Nahaa0711/Micromouse-UofT/Notes/MM Kahoot.md

\1.How many Prototypes have we made so far?
2.How many degrees of freedom does a Micromouse typically have? 
3.Pick a sensor we haven't used
4.Increasing **wheel diameter** tends to:  
    A. Improve torque but reduce top speed  
    B. Reduce ground clearance  
    C. Increase angular acceleration  
    D. Boost top speed but require more torque
