Nahaa0711/Micromouse-UofT/Important Links/LINKS.md

**Obsidian Documentation Github**
- https://github.com/AahanP711/Micromouse-Documentation
- contains the Obsidian repo!

**KiCad Tutorial**
- Installing KiCad
	- [installing KiCad](https://docs.google.com/document/d/1HKX35Z9dQBu9zBemlAzxbzjGxq4VL6n00p6JnvmTeCc/edit?usp=sharing)
- KiCad Starter Tutorial

**GIT HELP**
- [[Read Me]]
