Nahaa0711/Micromouse-UofT/KB/SLAM.md

The **Simultaneous Localization and Mapping (SLAM)** problem is the **holy grail** of autonomous navigation in unknown environments. It tackles the **chicken-and-egg dilemma**: how do you build a map if you don't know where you are, and how do you know where you are if you don't have a map? SLAM algorithms solve this by **concurrently estimating** both the agent's (robot's) pose (position and orientation) and the structure of its surrounding environment.

At its core, SLAM is a **probabilistic state estimation problem**. It fuses noisy, sequential sensor data (from LiDAR, cameras, IMUs, odometers, etc.) with motion models to recursively update a **joint probability distribution** over the robot's pose and the map features.

Key components and challenges include:

1. **Front-End (Perception & Odometry)**: This involves processing raw sensor data to extract useful information.
    - **Feature Extraction**: Identifying salient, repeatable landmarks or features (e.g., corners, edges, distinct points, planes) from sensor readings.
    - **Data Association**: The **"correspondence problem"** – correctly matching current sensor observations to previously observed map features or new features. This is _critical_ and prone to error in dynamic or feature-poor environments.
    - **Visual/Lidar Odometry**: Estimating the robot's relative motion between consecutive sensor frames. This provides a short-term, but drift-prone, pose estimate.
        
2. **Back-End (Optimization & Map Management)**: This component refines the pose and map estimates over time.
    - **State Estimation Techniques**:
        - **Filter-based SLAM** (e.g., Extended Kalman Filter (EKF) SLAM, Unscented Kalman Filter (UKF) SLAM, Particle Filter SLAM like FastSLAM): Recursively updates a single state estimate (or a set of particles) and its covariance. EKF-SLAM linearizes non-linear models, while particle filters handle multi-modal distributions.
        
        - **Graph-based SLAM**: Formulates the problem as a pose graph where nodes are robot poses/landmarks and edges are spatial constraints derived from sensor measurements or odometry. The optimal map and trajectory are found by solving a **nonlinear least-squares optimization problem** to minimize errors across the entire graph. This is often more scalable for large environments.
        
    - **Loop Closure Detection**: The **holy grail of consistency**. When the robot revisits a previously mapped area, loop closure algorithms (e.g., using Bag-of-Words for place recognition) detect this re-visitation. This allows for the **global correction of accumulated drift** in both the map and the robot's trajectory, pulling the entire map into a consistent state.
    
    - **Map Representation**: The environment can be represented as occupancy grids, point clouds, feature maps, or topological maps, each with trade-offs in detail, memory, and computational cost.

The primary challenges in SLAM stem from **sensor noise**, **data association ambiguity**, **computational complexity** (especially for large-scale or real-time applications), and operating in **dynamic environments** where the map itself changes. Despite these hurdles, ongoing research, particularly with the integration of machine learning and deep learning, continues to push the boundaries, making SLAM indispensable for autonomous vehicles, robotics, and augmented reality.
