Nahaa0711/Micromouse-UofT/Notes/Daniel's top 5 designs.md

Top 5 Designs
https://www.kerislab.jp/posts/2020-04-15-kerise-v5-coming/
https://github.com/Ojasp21/Micromouse?tab=readme-ov-file#about-the-project
https://github.com/sanjith1999/SINDiB-MicroMouse
https://github.com/kbumsik/WolfieMouse
https://github.com/opatiny/micromouse

Top 5 Vision Systems
https://github.com/emstef/Micromouse
https://github.com/Bugaddr/micromouse_rac_task
https://github.com/adam2392/ieee_micromouse
https://ianmhoffman.github.io/Micromouse/#wall-sensors
https://github.com/arnefmeyer/mousecam
https://www.xiaotiandai.com/robots/

Top 5 Mobility Systems
https://kyle-chan.github.io/projects/micromouse
https://gingineer95.github.io/2021/12/11/micromouse/
https://medium.com/@austinxiao/ieee-micromouse-2016-software-design-496653ff104d
https://github.com/ukmars/turn-tuner
https://github.com/gautam-dev-maker/mushak

weight
