Nahaa0711/Micromouse-UofT/Notes/Component Selection.md

BOOK - GERSTEIN BASEMENT
BOOK - MYHAL 360

syncsearch - avIlable rooms
BOOK - UC basement

Gideons favourite numbers - 6, 7

Micromouse Size - Full

Motor
https://www.pololu.com/product/5154
- encoder ( maybe find better encoder to reduce 3 degree error)
- buck boost converter since motor is 6V
	- or 6V battery

Wheels
https://ca.robotshop.com/products/pololu-wheel-32-7mm-black-pair?qd=e8f42962d0da45bdb59b51051e12fbfa
- maybe try 3D printing wheels too
