Nahaa0711/Micromouse-UofT/Micromouse/ECS_80_18_30_JGN_TR/ECS-80-18-30-JGN-TR.step

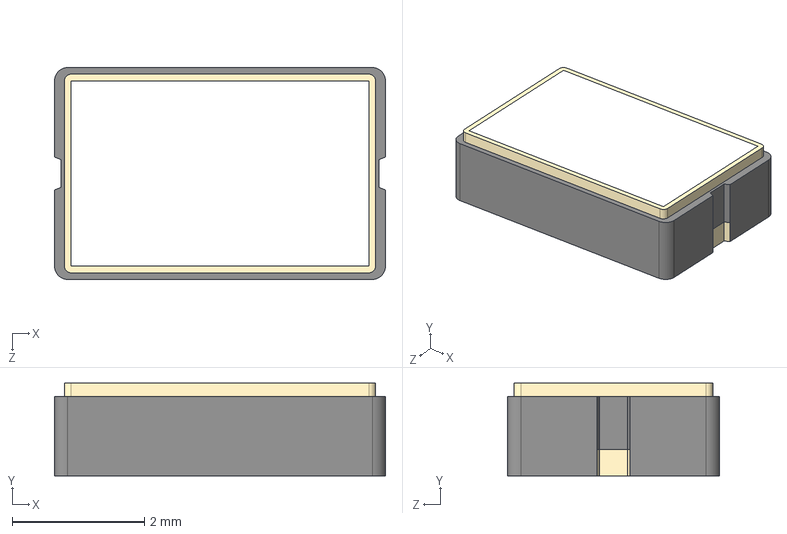
[picture p1: CAD file, 2026-10-29]
Micromouse/ECS_80_18_30_JGN_TR/ECS-80-18-30-JGN-TR.step
5.00 x 1.40 x 3.20 mm
