Nahaa0711/Micromouse-UofT/Micromouse/ICM_42688_P/ICM-42688-P.step

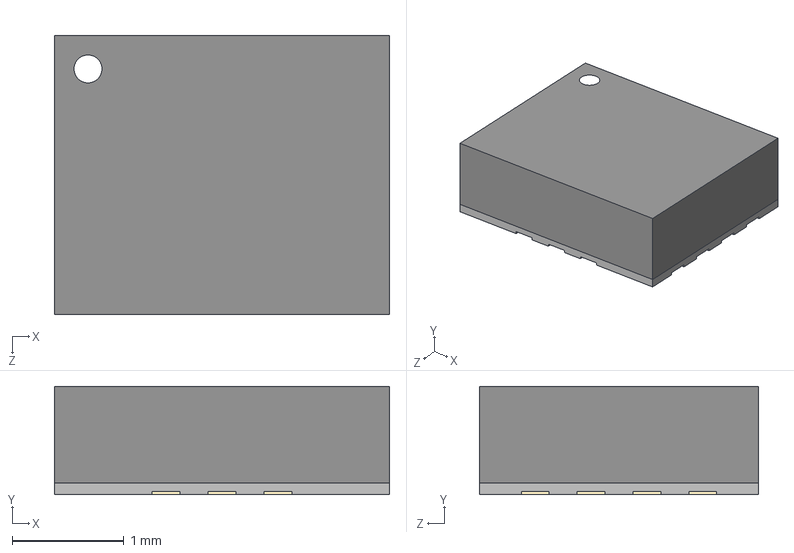
[picture p2: CAD file, 2025-10-28]
Micromouse/ICM_42688_P/ICM-42688-P.step
3.00 x 0.97 x 2.50 mm
