Nahaa0711/Micromouse-UofT/Micromouse/LIS2MDLTR/LIS2MDLTR.step

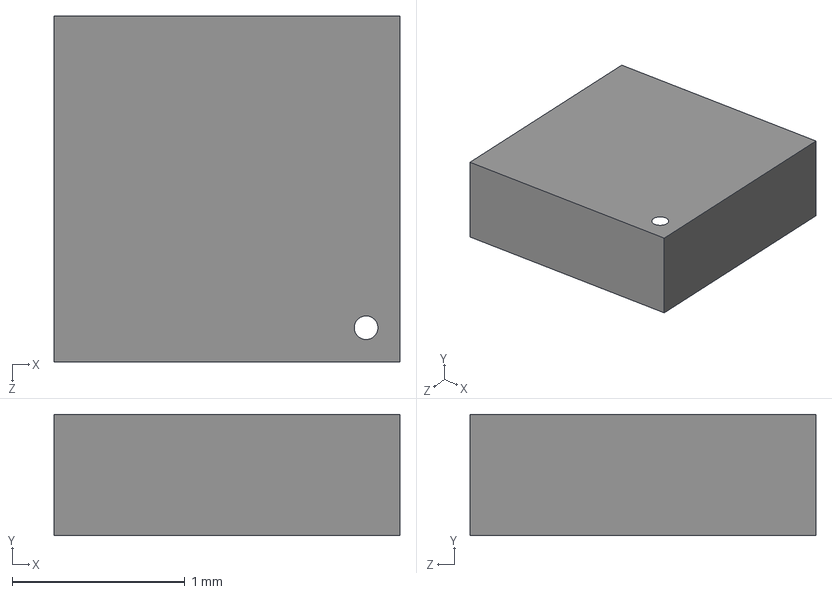
[picture p3: CAD file, 2025-10-28]
Micromouse/LIS2MDLTR/LIS2MDLTR.step
2.00 x 0.7 x 2.00 mm
