Nahaa0711/Micromouse-UofT/Micromouse/LP5907MFX_2_8_NOPB/LP5907MFX-2.8_NOPB.step

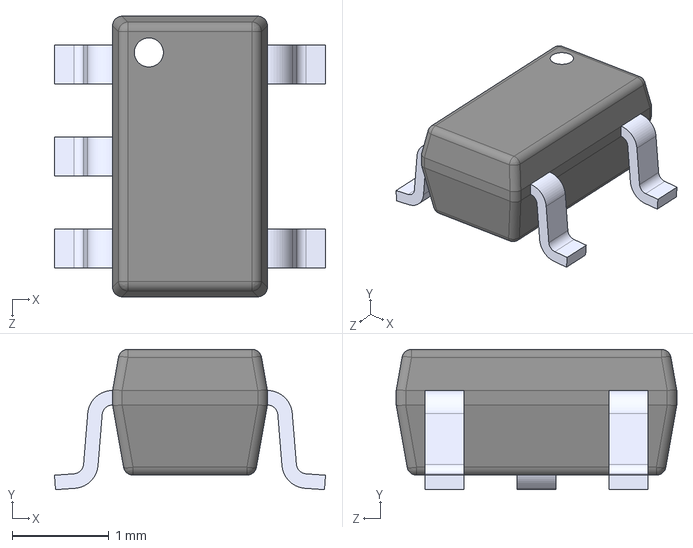
[picture p4: CAD file, 2025-11-02]
Micromouse/LP5907MFX_2_8_NOPB/LP5907MFX-2.8_NOPB.step
2.80 x 1.45 x 2.90 mm
