Nahaa0711/Micromouse-UofT/Micromouse/pcb_shape.DXF

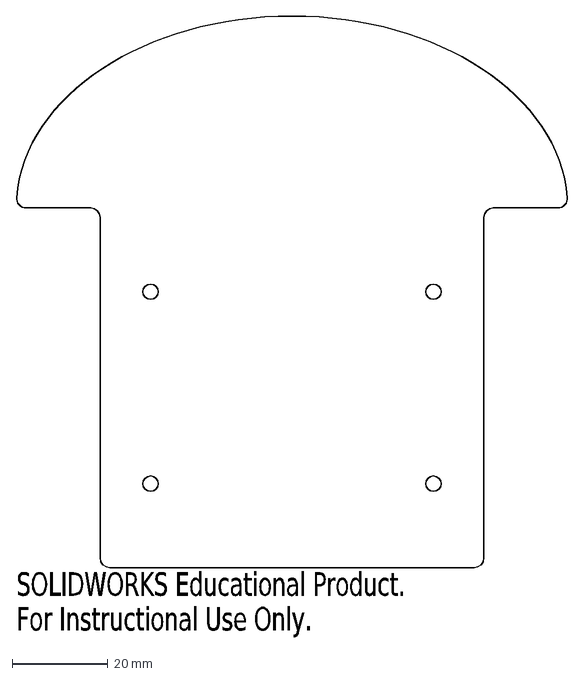
[picture p5: CAD file, 2026-08-07]
Micromouse/pcb_shape.DXF
SOLIDWORKS Educational Product.
For Instructional Use Only.
