Nahaa0711/Micromouse-UofT/Micromouse/TCA9544APWR/TCA9544APWR.step

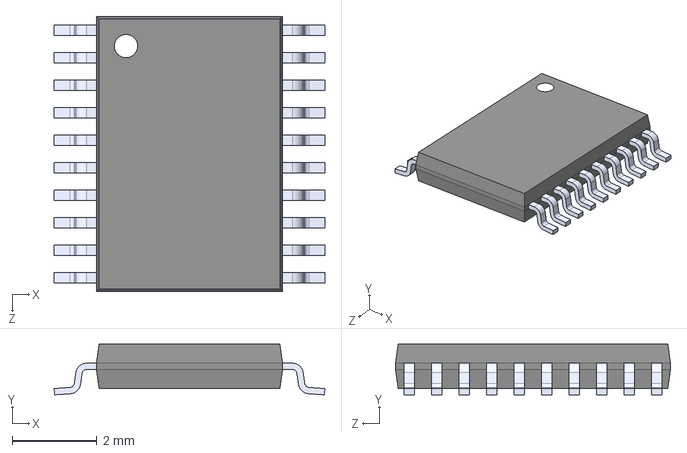
[picture p6: CAD file, 2025-11-02]
Micromouse/TCA9544APWR/TCA9544APWR.step
6.40 x 1.20 x 6.50 mm
