Nahaa0711/Micromouse-UofT/Micromouse/TPSM861253RDXR/TPSM861253RDXR.step

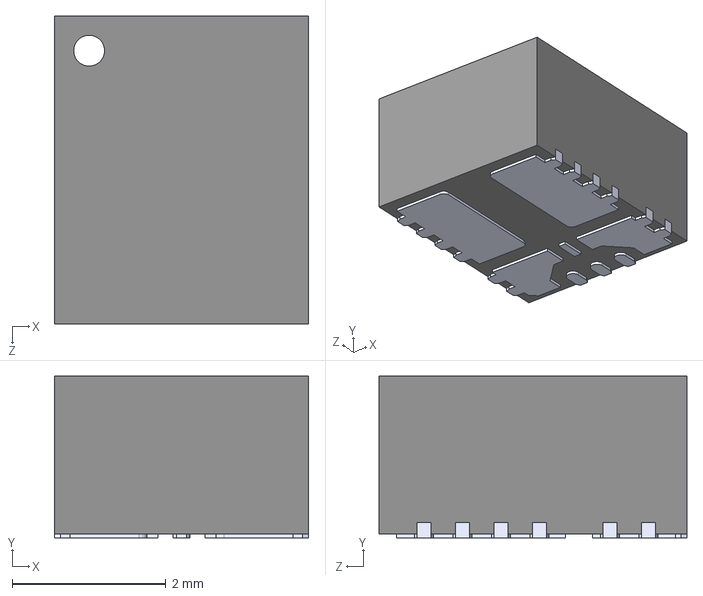
[picture p7: CAD file, 2025-10-28]
Micromouse/TPSM861253RDXR/TPSM861253RDXR.step
3.30 x 2.10 x 4.00 mm
