Nahaa0711/Micromouse-UofT/Micromouse/VL6180V1NR_1/VL6180V1NR_1.step

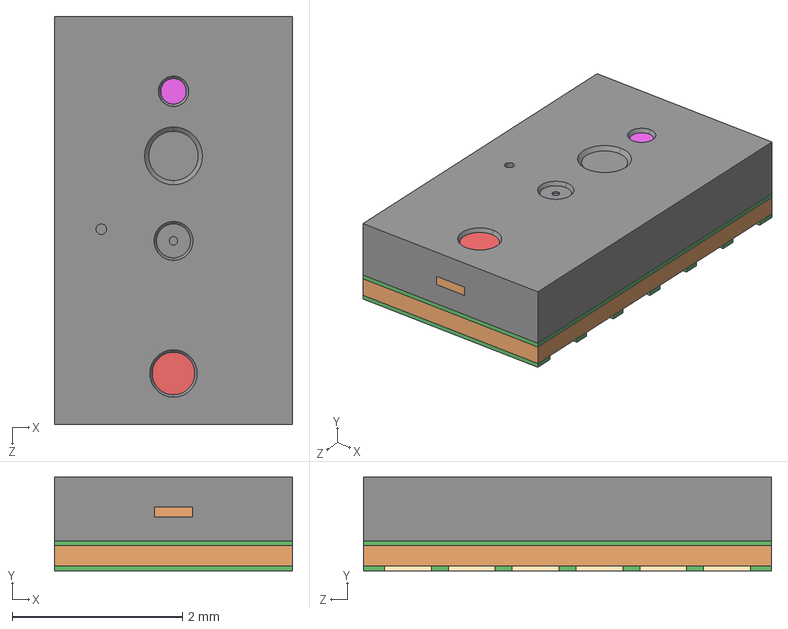
[picture p8: CAD file, 2025-10-28]
Micromouse/VL6180V1NR_1/VL6180V1NR_1.step
2.80 x 1.10 x 4.80 mm
