Nahaa0711/Micromouse-UofT/Micromouse/IR_sensor_project/IR_sensor_project.kicad_pcb

## KiCad design Micromouse/IR_sensor_project/IR_sensor_project.kicad_pcb (2026-10-29)

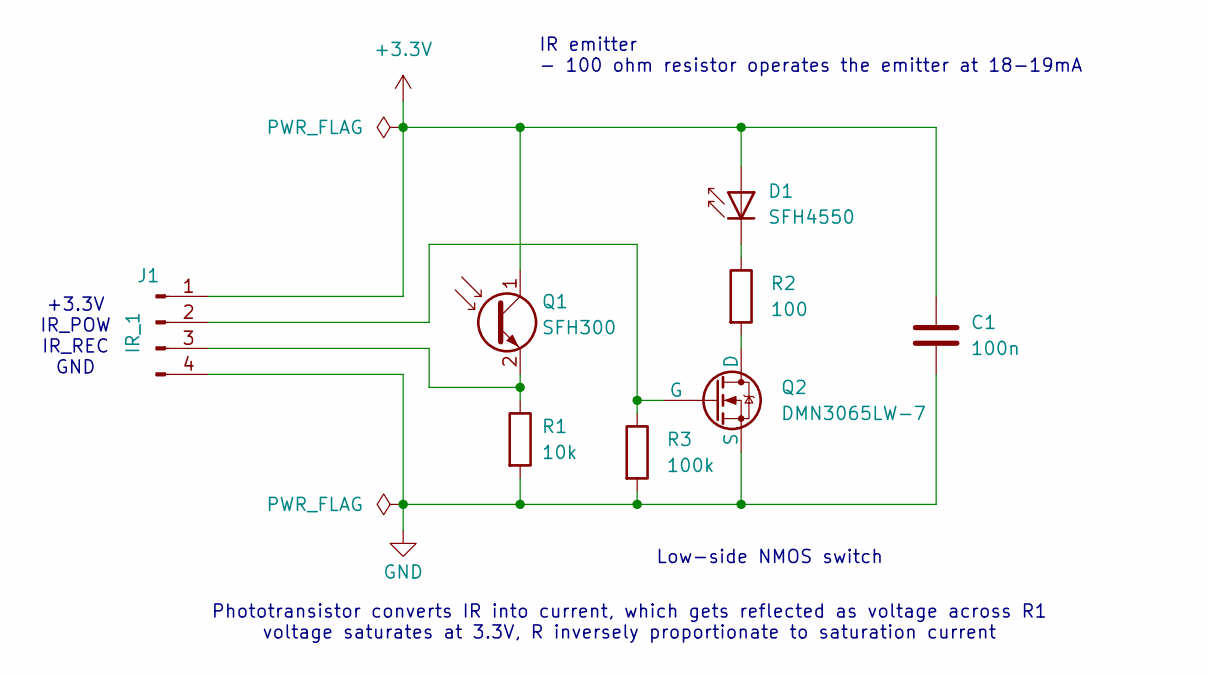
[picture p9: schematic IR_sensor_project.kicad_sch]

Parts:
C1: 100n; C_0603_1608Metric
D1: SFH4550; LED_D5.0mm_IRGrey
J1: IR_1; PinHeader_1x04_P2.00mm_Horizontal
Q1: SFH300; LED_D5.0mm_Clear
Q2: DMN3065LW-7
R1: 10k; R_0603_1608Metric
R2: 100; R_0603_1608Metric
R3: 100k; R_0603_1608Metric

Connections:
+3.3V: C1.1, D1.2 (A), J1.1, Q1.1 (C)
GND: C1.2, J1.4, Q2.3 (S), R1.2, R3.2
unnamed: D1.1 (K), R2.1
unnamed: J1.2, Q2.2 (G), R3.1
unnamed: J1.3, Q1.2 (E), R1.1
unnamed: Q2.1 (D), R2.2

Notes on the sheet:
Low-side NMOS switch
Phototransistor converts IR into current, which gets reflected as voltage across R1 voltage saturates at 3.3V, R inversely proportionate to saturation current
IR emitter - 100 ohm resistor operates the emitter at 18-19mA
+3.3V IR_POW IR_REC GND

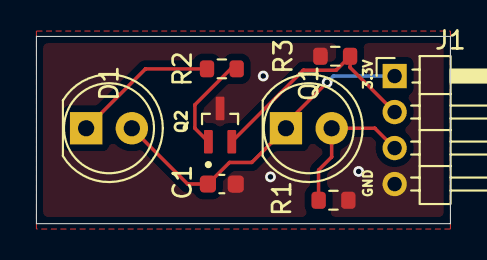
[picture p10: board IR_sensor_project.kicad_pcb from above]

Board: 2 copper layers, 23.0 x 10.4 mm, 8 parts (0 on the bottom side), 6 nets.
