Nahaa0711/Micromouse-UofT/Micromouse/ToF_sensor_project/ToF_sensor_project.kicad_pcb

## KiCad design Micromouse/ToF_sensor_project/ToF_sensor_project.kicad_pcb (2026-10-29)

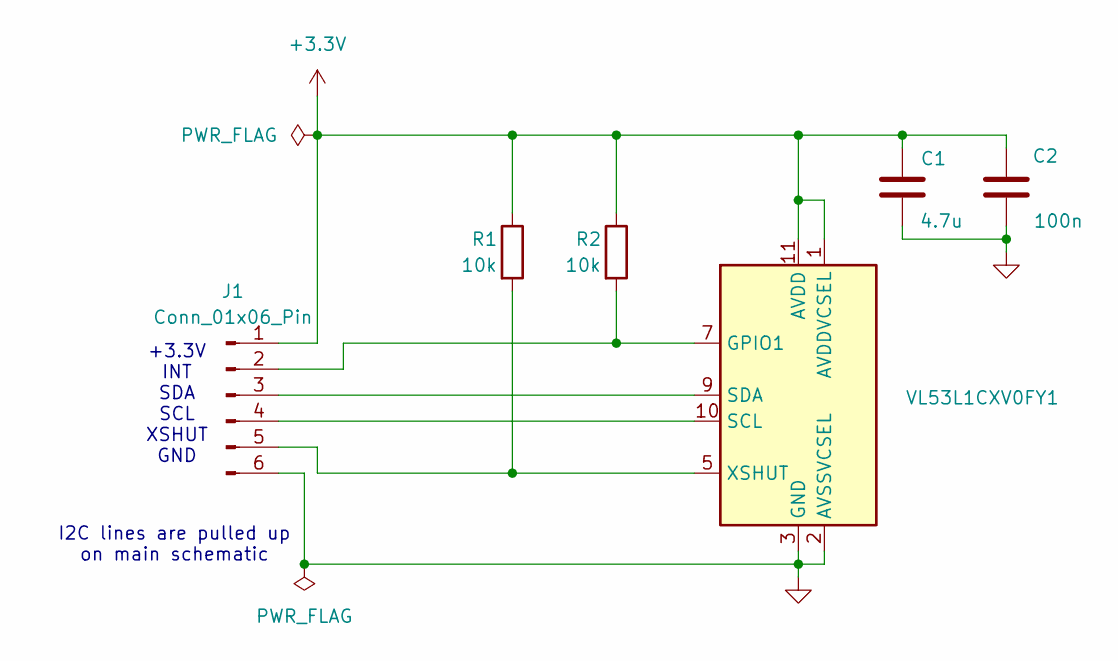
[picture p11: schematic ToF_sensor_project.kicad_sch]

Parts:
C1: 4.7u; C_0603_1608Metric
C2: 100n; C_0603_1608Metric
J1: Conn_01x06_Pin; PinHeader_1x06_P2.00mm_Horizontal
R1, R2: 10k; R_0603_1608Metric
U1: VL53L1CXV0FY1; ST_VL53L1x

Connections:
+3.3V: C1.2, C2.2, J1.1, R1.1, R2.1, U1.1 (AVDDVCSEL), U1.11 (AVDD)
GND: C1.1, C2.1, J1.6, U1.2 (AVSSVCSEL), U1.3 (GND), U1.4 (GND), U1.6 (GND), U1.12 (GND)
unnamed: J1.2, R2.2, U1.7 (GPIO1)
unnamed: J1.3, U1.9 (SDA)
unnamed: J1.4, U1.10 (SCL)
unnamed: J1.5, R1.2, U1.5 (XSHUT)

Notes on the sheet:
I2C lines are pulled up on main schematic
+3.3V INT SDA SCL XSHUT GND

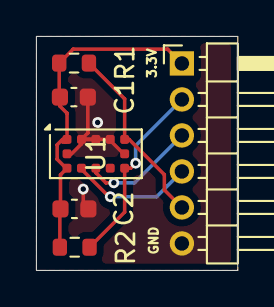
[picture p12: board ToF_sensor_project.kicad_pcb from above]

Board: 2 copper layers, 11.2 x 13.0 mm, 6 parts (0 on the bottom side), 6 nets.
