Nahaa0711/Micromouse-UofT/Micromouse/Micromouse_main_project/MicromouseSchematic.kicad_pcb

## KiCad design Micromouse/Micromouse_main_project/MicromouseSchematic.kicad_pcb (2026-10-29)

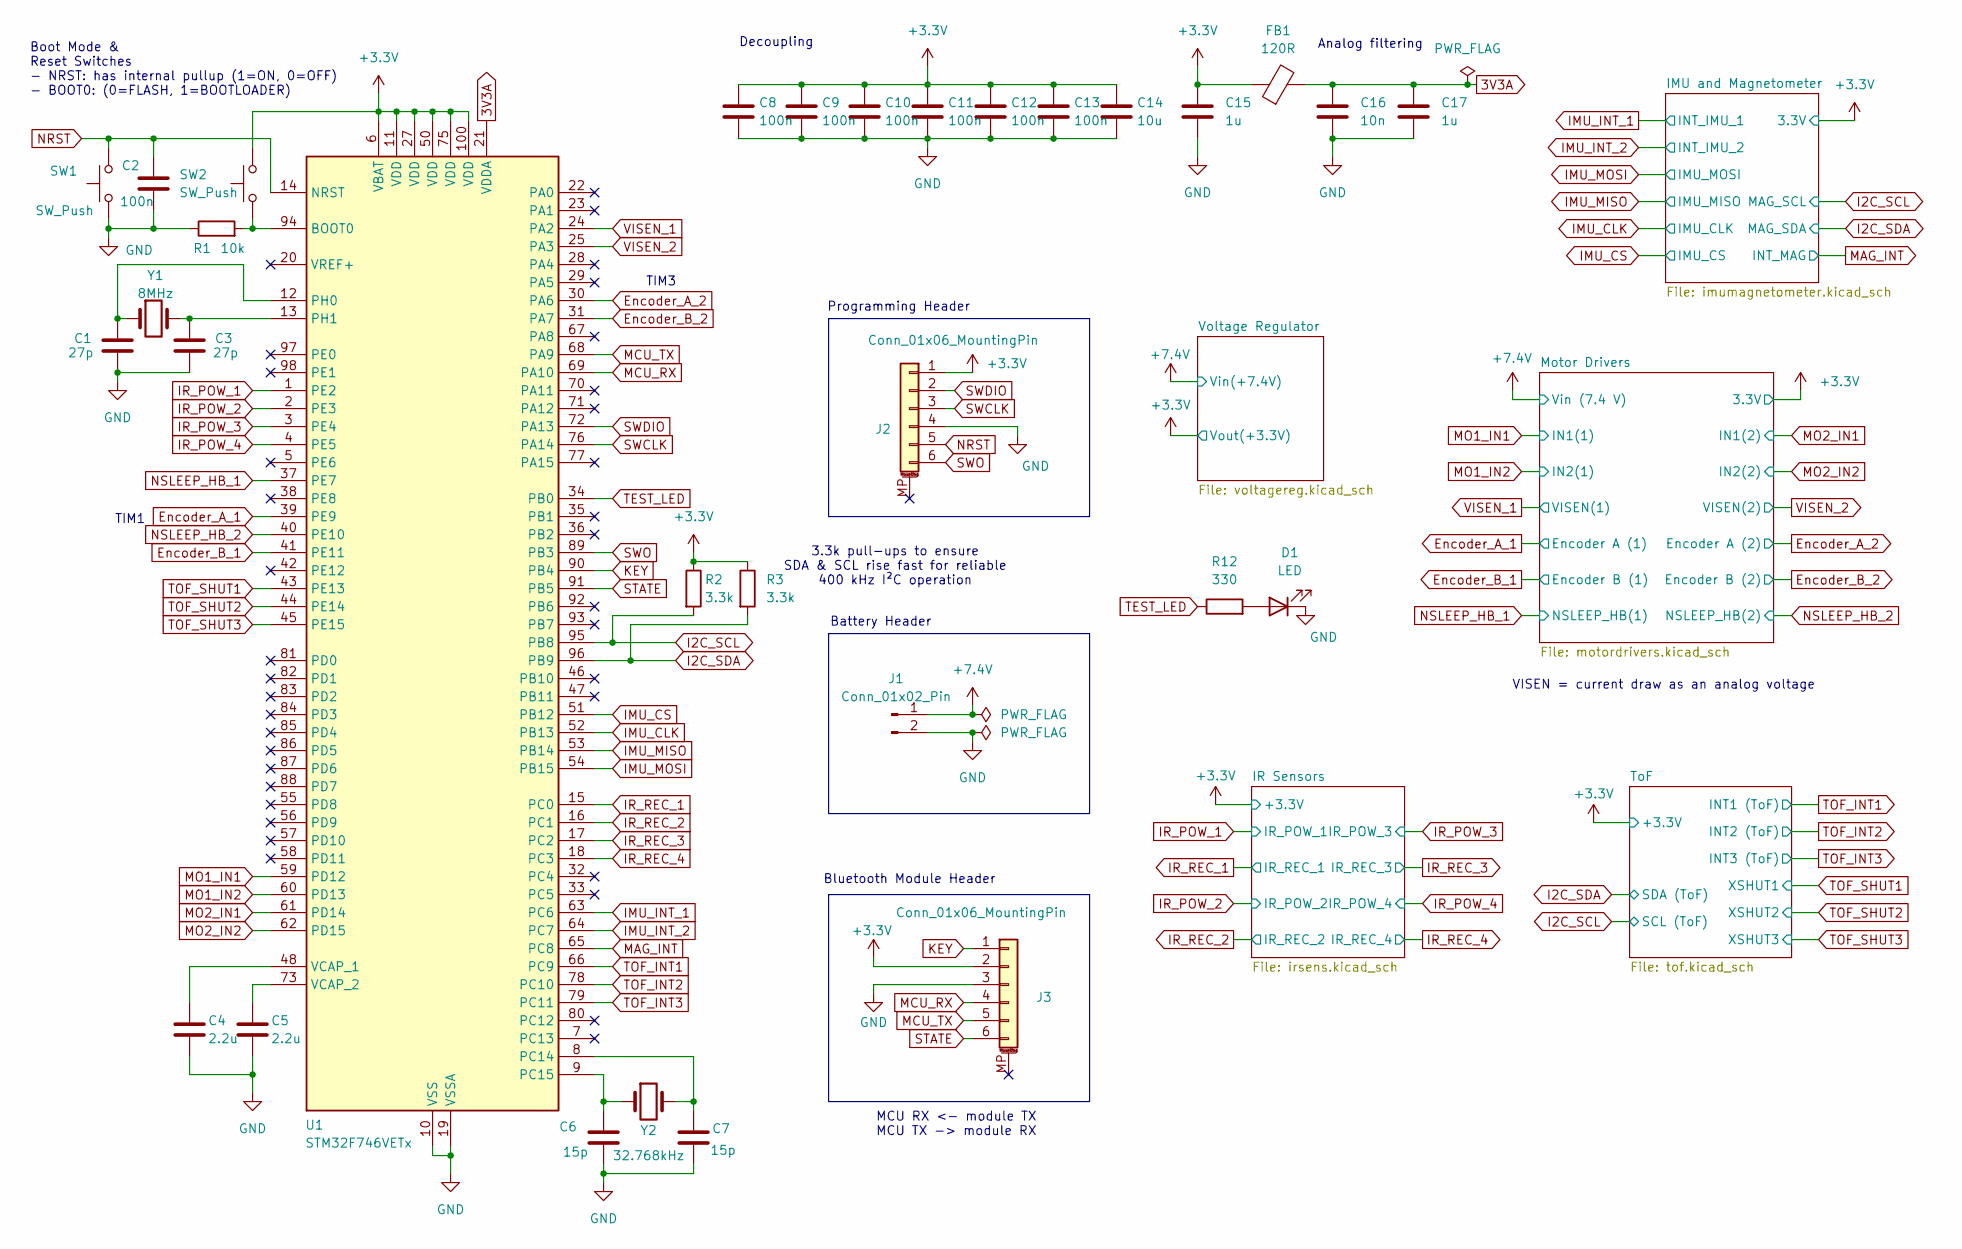
[picture p13: schematic MicromouseSchematic.kicad_sch]

Parts:
C1, C3: 27p; C_0603_1608Metric
C2, C8, C9, C10, C11, C12, C13: 100n; C_0603_1608Metric
C4, C5: 2.2u; C_0603_1608Metric
C6, C7: 15p; C_0603_1608Metric
C14: 10u; C_0603_1608Metric
C15, C17: 1u; C_0603_1608Metric
C16: 10n; C_0603_1608Metric
D1: LED; LED_0603_1608Metric
FB1: 120R; L_0603_1608Metric
J1: Conn_01x02_Pin; SolderWire-2.5sqmm_1x02_P7.2mm_D2.4mm_OD3.6mm_Relief
J2: Conn_01x06_MountingPin; PinHeader_1x06_P2.54mm_Vertical
J3: Conn_01x06_MountingPin; PinSocket_1x06_P2.54mm_Vertical
R1: 10k; R_0603_1608Metric
R2, R3: 3.3k; R_0603_1608Metric
R12: 330; R_0603_1608Metric
SW1, SW2: SW_Push; SW_SPST_SKQG_WithStem
U1: STM32F746VETx; LQFP-100_14x14mm_P0.5mm
Y1: 8MHz; XTAL_ECS-80-18-30-JGN-TR
Y2: 32.768kHz; XTAL_ECS-31B_ECS

Connections:
3V3A: C16.1, C17.1, FB1.2, U1.21 (VDDA)
+3.3V: C8.1, C9.1, C10.1, C11.1, C12.1, C13.1, C14.1, C15.1, FB1.1, J2.1, J3.2, R2.1, R3.1, SW2.2, U1.6 (VBAT), U1.11 (VDD), U1.27 (VDD), U1.50 (VDD), U1.75 (VDD), U1.100 (VDD); also elsewhere on the board
+7.4V: J1.1; also elsewhere on the board
Encoder_A_1: U1.39 (PE9); also elsewhere on the board
Encoder_A_2: U1.30 (PA6); also elsewhere on the board
Encoder_B_1: U1.41 (PE11); also elsewhere on the board
Encoder_B_2: U1.31 (PA7); also elsewhere on the board
GND: C1.1, C2.2, C3.1, C4.2, C5.2, C6.2, C7.2, C8.2, C9.2, C10.2, C11.2, C12.2, C13.2, C14.2, C15.2, C16.2, C17.2, D1.1 (K), J1.2, J2.4, J3.3, R1.1, SW1.1, U1.10 (VSS), U1.19 (VSSA), U1.26 (VSS), U1.49 (VSS), U1.74 (VSS), U1.99 (VSS); also elsewhere on the board
I2C_SCL: R2.2, U1.95 (PB8); also elsewhere on the board
I2C_SDA: R3.2, U1.96 (PB9); also elsewhere on the board
IMU_CLK: U1.52 (PB13); also elsewhere on the board
IMU_CS: U1.51 (PB12); also elsewhere on the board
IMU_INT_1: U1.63 (PC6); also elsewhere on the board
IMU_INT_2: U1.64 (PC7); also elsewhere on the board
IMU_MISO: U1.53 (PB14); also elsewhere on the board
IMU_MOSI: U1.54 (PB15); also elsewhere on the board
IR_POW_1: U1.1 (PE2); also elsewhere on the board
IR_POW_2: U1.2 (PE3); also elsewhere on the board
IR_POW_3: U1.3 (PE4); also elsewhere on the board
IR_POW_4: U1.4 (PE5); also elsewhere on the board
IR_REC_1: U1.15 (PC0); also elsewhere on the board
IR_REC_2: U1.16 (PC1); also elsewhere on the board
IR_REC_3: U1.17 (PC2); also elsewhere on the board
IR_REC_4: U1.18 (PC3); also elsewhere on the board
KEY: J3.1, U1.90 (PB4)
MAG_INT: U1.65 (PC8); also elsewhere on the board
MCU_RX: J3.4, U1.69 (PA10)
MCU_TX: J3.5, U1.68 (PA9)
MO1_IN1: U1.59 (PD12); also elsewhere on the board
MO1_IN2: U1.60 (PD13); also elsewhere on the board
MO2_IN1: U1.61 (PD14); also elsewhere on the board
MO2_IN2: U1.62 (PD15); also elsewhere on the board
NRST: C2.1, J2.5, SW1.2, U1.14 (NRST)
NSLEEP_HB_1: U1.37 (PE7); also elsewhere on the board
NSLEEP_HB_2: U1.40 (PE10); also elsewhere on the board
unnamed: D1.2 (A), R12.2
unnamed: R1.2, SW2.1, U1.94 (BOOT0)
unnamed: C7.1, U1.8 (PC14), Y2.2
unnamed: C6.1, U1.9 (PC15), Y2.1
unnamed: C1.2, U1.12 (PH0), Y1.1
unnamed: C3.2, U1.13 (PH1), Y1.2
unnamed: C4.1, U1.48 (VCAP_1)
unnamed: C5.1, U1.73 (VCAP_2)
STATE: J3.6, U1.91 (PB5)
SWCLK: J2.3, U1.76 (PA14)
SWDIO: J2.2, U1.72 (PA13)
SWO: J2.6, U1.89 (PB3)
TEST_LED: R12.1, U1.34 (PB0)
TOF_INT1: U1.66 (PC9); also elsewhere on the board
TOF_INT2: U1.78 (PC10); also elsewhere on the board
TOF_INT3: U1.79 (PC11); also elsewhere on the board
TOF_SHUT1: U1.43 (PE13); also elsewhere on the board
TOF_SHUT2: U1.44 (PE14); also elsewhere on the board
TOF_SHUT3: U1.45 (PE15); also elsewhere on the board
VISEN_1: U1.24 (PA2); also elsewhere on the board
VISEN_2: U1.25 (PA3); also elsewhere on the board

Notes on the sheet:
Battery Header
Boot Mode & Reset Switches - NRST: has internal pullup (1=ON, 0=OFF) - BOOT0: (0=FLASH, 1=BOOTLOADER)
VISEN = current draw as an analog voltage
3.3k pull-ups to ensure SDA & SCL rise fast for reliable 400 kHz I²C operation
Bluetooth Module Header
TIM1
Decoupling
Programming Header
TIM3
Analog filtering
MCU RX <- module TX MCU TX -> module RX

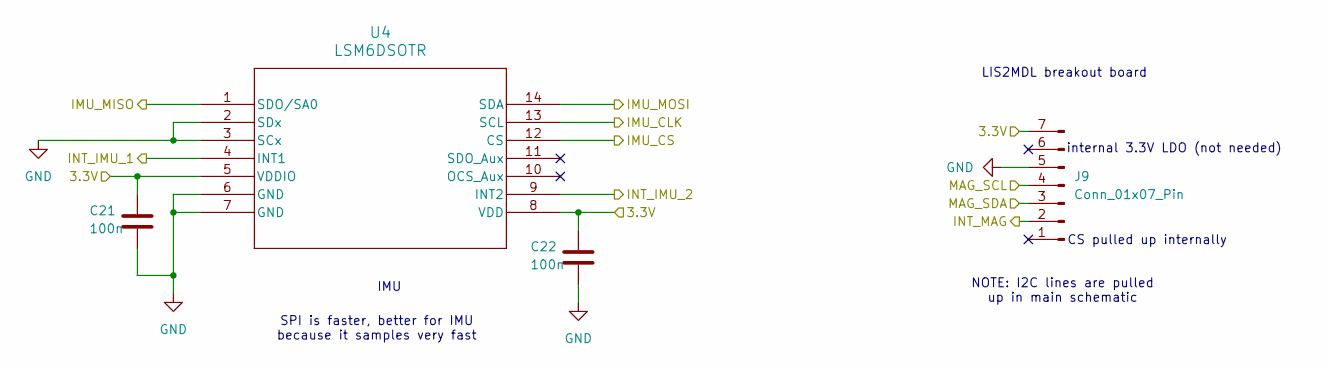
[picture p14: schematic imumagnetometer.kicad_sch]

Parts:
C21, C22: 100n; C_0603_1608Metric
J9: Conn_01x07_Pin; PinSocket_1x07_P2.54mm_Vertical
U4: LSM6DSOTR; LGA-14L_2P5X3X0P86_STM

Connections:
+3.3V: C21.1, C22.1, J9.7, U4.5 (VDDIO), U4.8 (VDD); also elsewhere on the board
GND: C21.2, C22.2, J9.5, U4.2 (SDx), U4.3 (SCx), U4.6 (GND), U4.7 (GND); also elsewhere on the board
I2C_SCL: J9.4; also elsewhere on the board
I2C_SDA: J9.3; also elsewhere on the board
IMU_CLK: U4.13 (SCL); also elsewhere on the board
IMU_CS: U4.12 (CS); also elsewhere on the board
IMU_INT_1: U4.4 (INT1); also elsewhere on the board
IMU_INT_2: U4.9 (INT2); also elsewhere on the board
IMU_MISO: U4.1 (SDO/SA0); also elsewhere on the board
IMU_MOSI: U4.14 (SDA); also elsewhere on the board
MAG_INT: J9.2; also elsewhere on the board

Notes on the sheet:
CS pulled up internally
internal 3.3V LDO (not needed)
LIS2MDL breakout board
IMU
NOTE: I2C lines are pulled up in main schematic
SPI is faster, better for IMU because it samples very fast

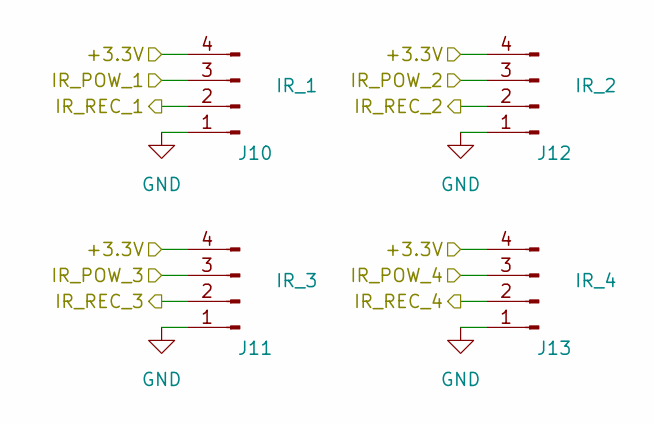
[picture p15: schematic irsens.kicad_sch]

Parts:
J10: IR_1; PinSocket_1x04_P2.00mm_Vertical
J11: IR_3; PinSocket_1x04_P2.00mm_Vertical
J12: IR_2; PinSocket_1x04_P2.00mm_Vertical
J13: IR_4; PinSocket_1x04_P2.00mm_Vertical

Connections:
+3.3V: J10.4, J11.4, J12.4, J13.4; also elsewhere on the board
GND: J10.1, J11.1, J12.1, J13.1; also elsewhere on the board
IR_POW_1: J10.3; also elsewhere on the board
IR_POW_2: J12.3; also elsewhere on the board
IR_POW_3: J11.3; also elsewhere on the board
IR_POW_4: J13.3; also elsewhere on the board
IR_REC_1: J10.2; also elsewhere on the board
IR_REC_2: J12.2; also elsewhere on the board
IR_REC_3: J11.2; also elsewhere on the board
IR_REC_4: J13.2; also elsewhere on the board

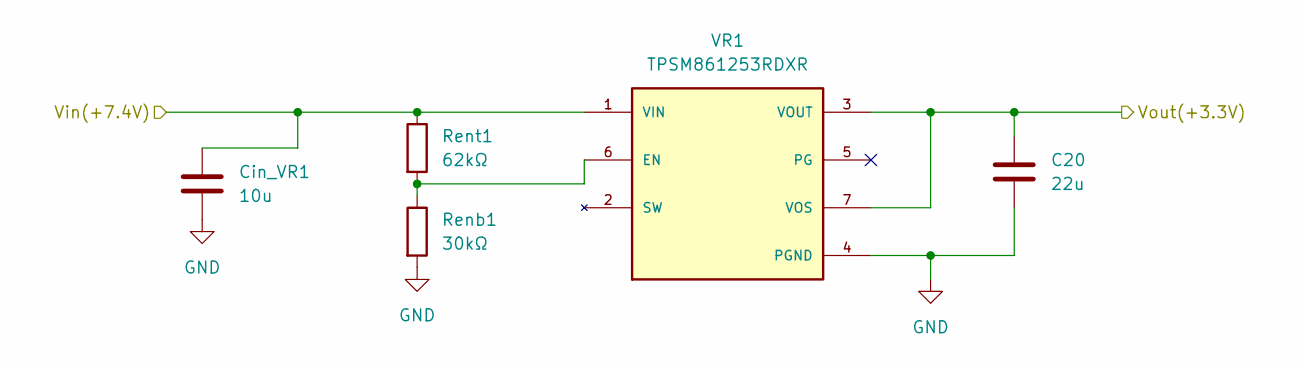
[picture p16: schematic voltagereg.kicad_sch]

Parts:
C20: 22u; C_0603_1608Metric
Cin_VR1: 10u; C_0603_1608Metric
Renb1: 30kΩ; R_0603_1608Metric
Rent1: 62kΩ; R_0603_1608Metric
VR1: TPSM861253RDXR; PARTREV B

Connections:
+3.3V: C20.1, VR1.3 (VOUT), VR1.7 (VOS), VR1.14, VR1.15, VR1.16, VR1.17, VR1.18, VR1.19; also elsewhere on the board
+7.4V: Cin_VR1.1, Rent1.1, VR1.1 (VIN); also elsewhere on the board
GND: C20.2, Cin_VR1.2, Renb1.2, VR1.4 (PGND); also elsewhere on the board
unnamed: Renb1.1, Rent1.2, VR1.6 (EN)

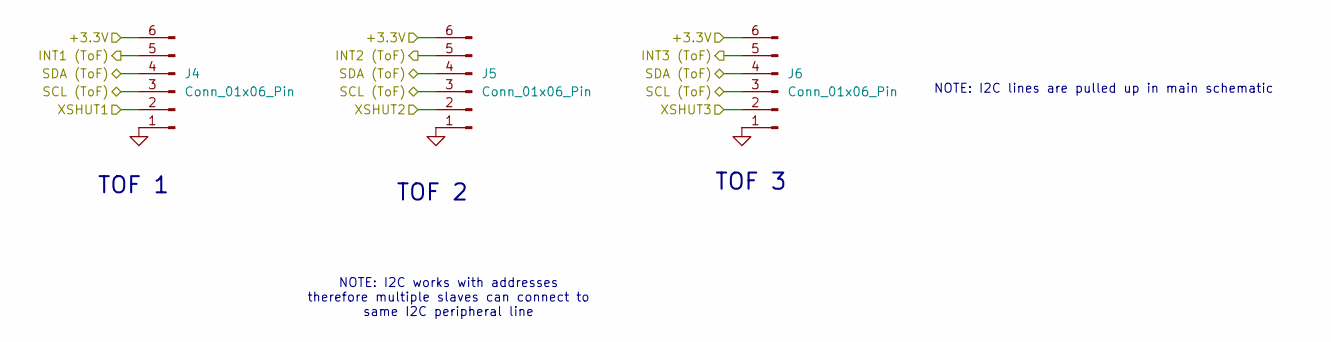
[picture p17: schematic tof.kicad_sch]

Parts:
J4, J5, J6: Conn_01x06_Pin; PinSocket_1x06_P2.00mm_Vertical

Connections:
+3.3V: J4.6, J5.6, J6.6; also elsewhere on the board
GND: J4.1, J5.1, J6.1; also elsewhere on the board
I2C_SCL: J4.3, J5.3, J6.3; also elsewhere on the board
I2C_SDA: J4.4, J5.4, J6.4; also elsewhere on the board
TOF_INT1: J4.5; also elsewhere on the board
TOF_INT2: J5.5; also elsewhere on the board
TOF_INT3: J6.5; also elsewhere on the board
TOF_SHUT1: J4.2; also elsewhere on the board
TOF_SHUT2: J5.2; also elsewhere on the board
TOF_SHUT3: J6.2; also elsewhere on the board

Notes on the sheet:
TOF 3
NOTE: I2C lines are pulled up in main schematic
TOF 2
TOF 1
NOTE: I2C works with addresses therefore multiple slaves can connect to same I2C peripheral line

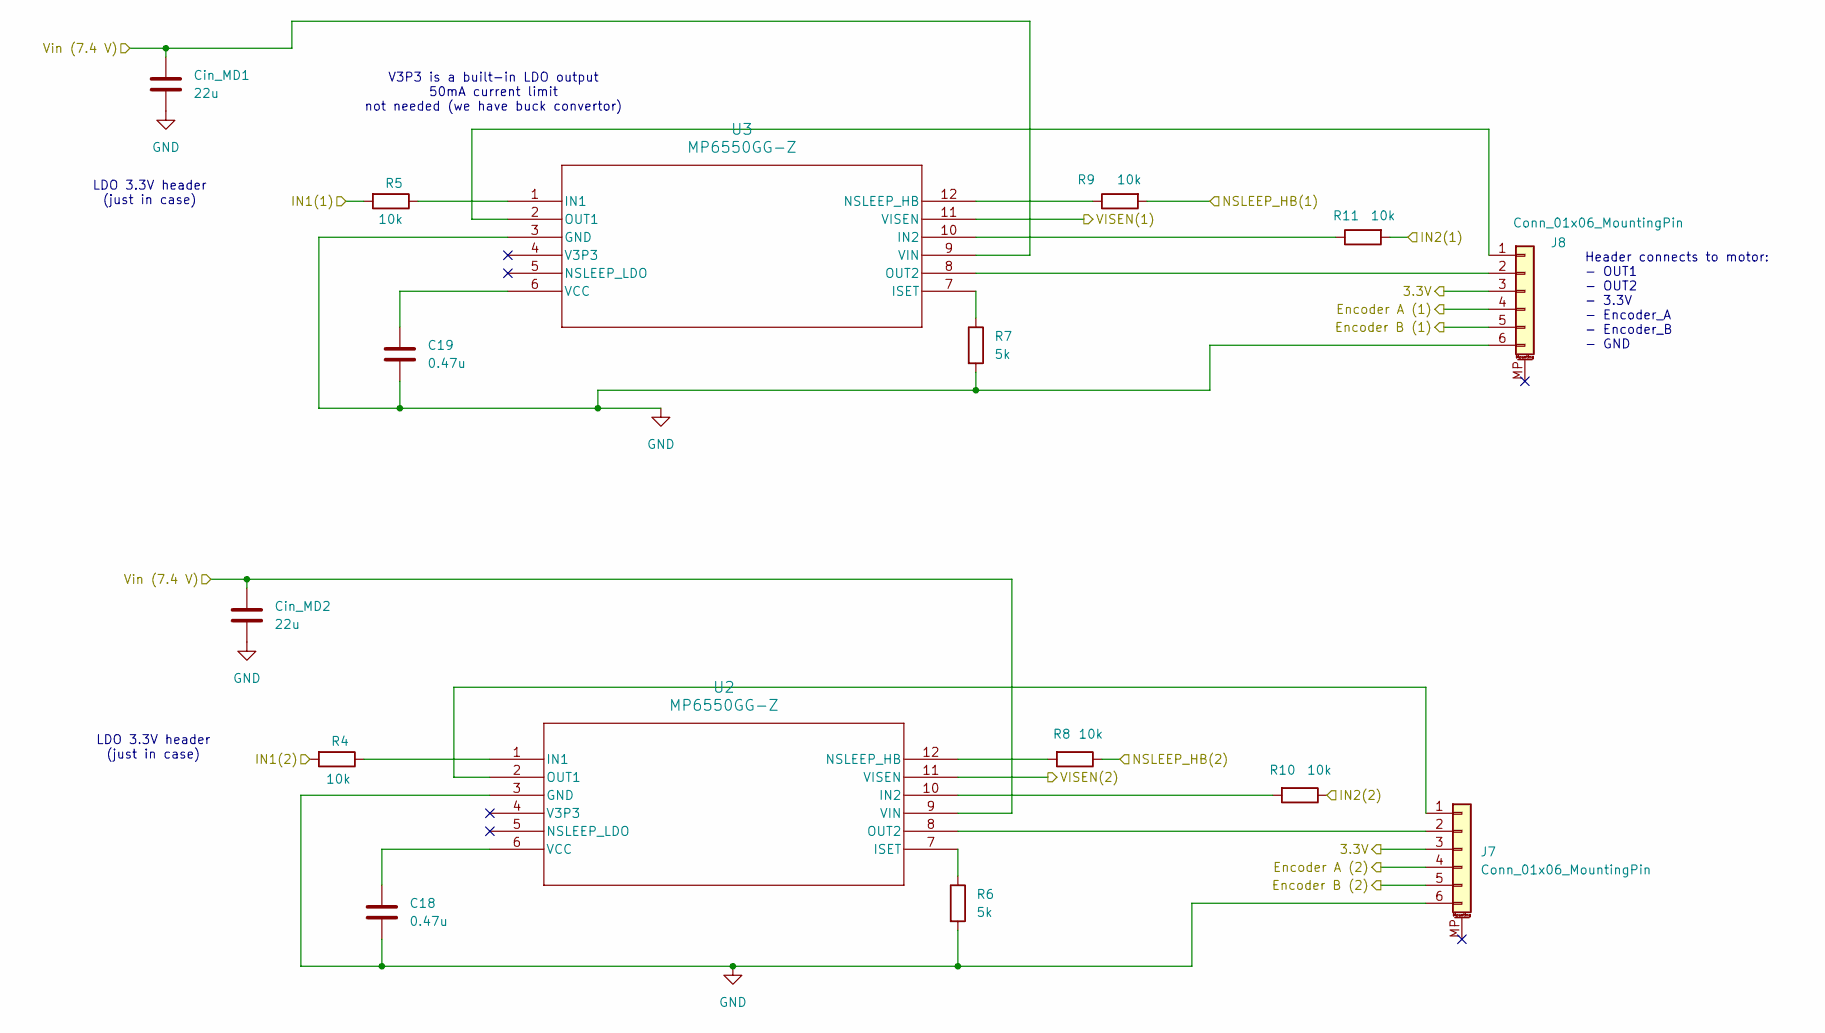
[picture p18: schematic motordrivers.kicad_sch]

Parts:
C18, C19: 0.47u; C_0603_1608Metric
Cin_MD1, Cin_MD2: 22u; C_0603_1608Metric
J7, J8: Conn_01x06_MountingPin; JST_SH_BM06B-SRSS-TB_1x06-1MP_P1.00mm_Vertical
R4, R5, R8, R9, R10, R11: 10k; R_0603_1608Metric
R6, R7: 5k; R_0603_1608Metric
U2, U3: MP6550GG-Z; IC12_MP6550_MNP

Connections:
+3.3V: J7.3, J8.3; also elsewhere on the board
+7.4V: Cin_MD1.1, Cin_MD2.1, U2.9 (VIN), U3.9 (VIN); also elsewhere on the board
Encoder_A_1: J8.4; also elsewhere on the board
Encoder_A_2: J7.4; also elsewhere on the board
Encoder_B_1: J8.5; also elsewhere on the board
Encoder_B_2: J7.5; also elsewhere on the board
GND: C18.2, C19.2, Cin_MD1.2, Cin_MD2.2, J7.6, J8.6, R6.2, R7.2, U2.3 (GND), U3.3 (GND); also elsewhere on the board
MO1_IN1: R5.2; also elsewhere on the board
MO1_IN2: R11.2; also elsewhere on the board
MO2_IN1: R4.2; also elsewhere on the board
MO2_IN2: R10.1; also elsewhere on the board
NSLEEP_HB_1: R9.2; also elsewhere on the board
NSLEEP_HB_2: R8.1; also elsewhere on the board
unnamed: J7.1, U2.2 (OUT1)
unnamed: J7.2, U2.8 (OUT2)
unnamed: J8.1, U3.2 (OUT1)
unnamed: J8.2, U3.8 (OUT2)
unnamed: R4.1, U2.1 (IN1)
unnamed: R10.2, U2.10 (IN2)
unnamed: R6.1, U2.7 (ISET)
unnamed: R8.2, U2.12 (NSLEEP_HB)
unnamed: C18.1, U2.6 (VCC)
unnamed: R5.1, U3.1 (IN1)
unnamed: R11.1, U3.10 (IN2)
unnamed: R7.1, U3.7 (ISET)
unnamed: R9.1, U3.12 (NSLEEP_HB)
unnamed: C19.1, U3.6 (VCC)
VISEN_1: U3.11 (VISEN); also elsewhere on the board
VISEN_2: U2.11 (VISEN); also elsewhere on the board

Notes on the sheet:
LDO 3.3V header (just in case)
Header connects to motor: - OUT1 - OUT2 - 3.3V - Encoder_A - Encoder_B - GND
V3P3 is a built-in LDO output 50mA current limit not needed (we have buck convertor)

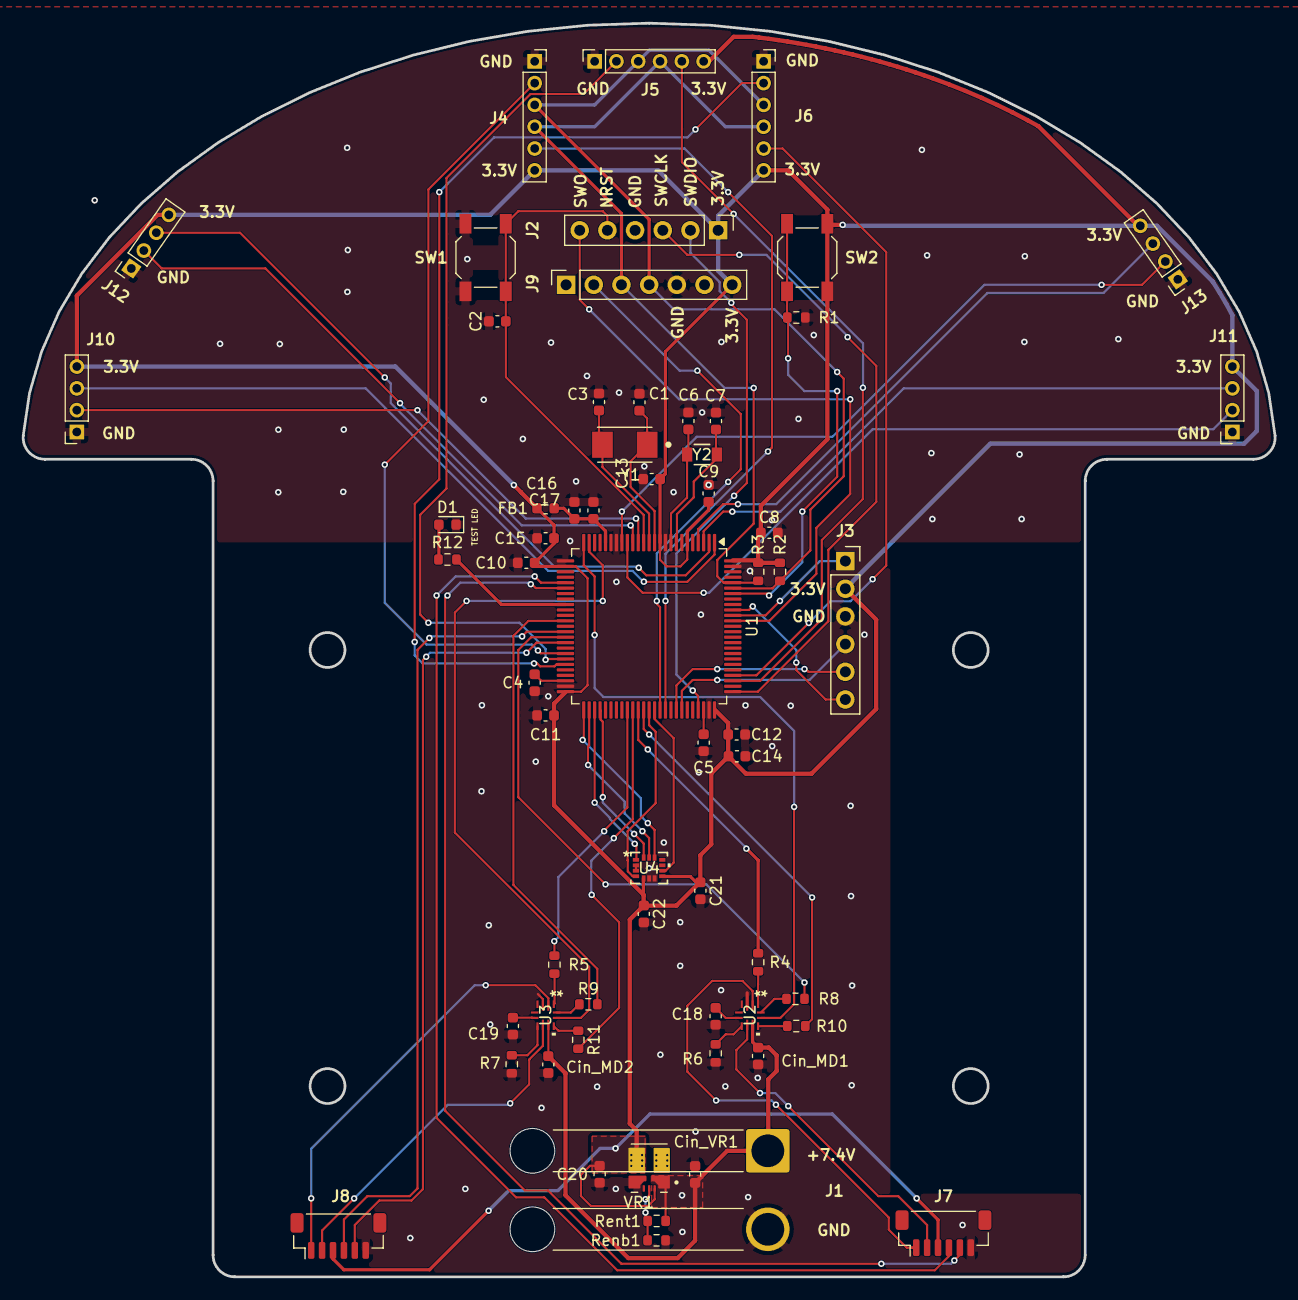
[picture p19: board MicromouseSchematic.kicad_pcb from above]

Board: 2 copper layers, 114.8 x 115.0 mm, 63 parts (0 on the bottom side), 71 nets.
