Nahaa0711/Micromouse-UofT/firmware/micro-mind-to-motor/Core/Src/main.c

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
/* Includes ------------------------------------------------------------------*/
#include "main.h"

/* USER CODE BEGIN Includes */
#include <stdio.h>
/* USER CODE END Includes */

/* USER CODE BEGIN PD */
/* Motor input pins -> TIM4 channels */
#define MO1_IN1   TIM_CHANNEL_1   // PD12  TIM4_CH1  Motor 1 (U3, J8)
#define MO1_IN2   TIM_CHANNEL_2   // PD13  TIM4_CH2
#define MO2_IN1   TIM_CHANNEL_3   // PD14  TIM4_CH3  Motor 2 (U2, J7)
#define MO2_IN2   TIM_CHANNEL_4   // PD15  TIM4_CH4
#define LINK_TIMEOUT_MS       400U
#define STATUS_PERIOD_MS      100U
#define RX_LINE_CAPACITY       16U
/* USER CODE END PD */

ADC_HandleTypeDef hadc1;
ADC_HandleTypeDef hadc2;

TIM_HandleTypeDef htim1;
TIM_HandleTypeDef htim3;
TIM_HandleTypeDef htim4;

UART_HandleTypeDef huart1;

void SystemClock_Config(void);
static void MPU_Config(void);
static void MX_GPIO_Init(void);
static void MX_ADC1_Init(void);
static void MX_TIM1_Init(void);
static void MX_TIM3_Init(void);
static void MX_TIM4_Init(void);
static void MX_ADC2_Init(void);
static void MX_USART1_UART_Init(void);
/* USER CODE BEGIN PFP */
static void Motors_Stop(void);
static void Motors_SetWheelPercent(uint8_t left, uint8_t right);
static uint8_t Parse_Wheel_Command(const char *line, uint8_t length,
                                   uint8_t *left, uint8_t *right);
/* USER CODE END PFP */

/* USER CODE BEGIN 0 */
static void Motors_Stop(void)
{
  __HAL_TIM_SET_COMPARE(&htim4, MO1_IN1, 0U);
  __HAL_TIM_SET_COMPARE(&htim4, MO1_IN2, 0U);
  __HAL_TIM_SET_COMPARE(&htim4, MO2_IN1, 0U);
  __HAL_TIM_SET_COMPARE(&htim4, MO2_IN2, 0U);

  HAL_GPIO_WritePin(NSLEEP_HB_1_GPIO_Port, NSLEEP_HB_1_Pin, GPIO_PIN_RESET);
  HAL_GPIO_WritePin(NSLEEP_HB_2_GPIO_Port, NSLEEP_HB_2_Pin, GPIO_PIN_RESET);
  HAL_GPIO_WritePin(GPIOB, GPIO_PIN_0, GPIO_PIN_RESET);
}

static void Motors_SetWheelPercent(uint8_t left, uint8_t right)
{
  uint32_t period = __HAL_TIM_GET_AUTORELOAD(&htim4) + 1U;
  uint32_t left_duty = (period * left) / 100U;
  uint32_t right_duty = (period * right) / 100U;

  /* Motor 1 (J8) is treated as the left wheel; Motor 2 (J7) as the right. */
  __HAL_TIM_SET_COMPARE(&htim4, MO1_IN1, left_duty);
  __HAL_TIM_SET_COMPARE(&htim4, MO1_IN2, 0U);
  __HAL_TIM_SET_COMPARE(&htim4, MO2_IN1, right_duty);
  __HAL_TIM_SET_COMPARE(&htim4, MO2_IN2, 0U);

  HAL_GPIO_WritePin(NSLEEP_HB_1_GPIO_Port, NSLEEP_HB_1_Pin,
                    left > 0U ? GPIO_PIN_SET : GPIO_PIN_RESET);
  HAL_GPIO_WritePin(NSLEEP_HB_2_GPIO_Port, NSLEEP_HB_2_Pin,
                    right > 0U ? GPIO_PIN_SET : GPIO_PIN_RESET);
  HAL_GPIO_WritePin(GPIOB, GPIO_PIN_0,
                    (left > 0U || right > 0U) ? GPIO_PIN_SET : GPIO_PIN_RESET);
}

static uint8_t Parse_Percent(const char *line, uint8_t length,
                             uint8_t *at, uint8_t *value)
{
  uint16_t total = 0U;
  uint8_t digits = 0U;

  while (*at < length && line[*at] >= '0' && line[*at] <= '9' && digits < 4U)
  {
    total = (uint16_t)(total * 10U + (uint16_t)(line[*at] - '0'));
    (*at)++;
    digits++;
  }
  if (digits == 0U || digits > 3U || total > 100U)
  {
    return 0U;
  }
  *value = (uint8_t)total;
  return 1U;
}

static uint8_t Parse_Wheel_Command(const char *line, uint8_t length,
                                   uint8_t *left, uint8_t *right)
{
  uint8_t at = 1U;

  if (length < 4U || line[0] != 'W' ||
      Parse_Percent(line, length, &at, left) == 0U ||
      at >= length || line[at++] != ',' ||
      Parse_Percent(line, length, &at, right) == 0U ||
      at != length)
  {
    return 0U;
  }
  return 1U;
}

/* USER CODE END 0 */

/**
  * @brief  The application entry point.
  * @retval int
  */
int main(void)
{

  /* USER CODE BEGIN 1 */
  static const uint8_t identity[] = "I mind2motor 1\r\n";
  uint8_t received_byte = 0U;
  char rx_line[RX_LINE_CAPACITY];
  uint8_t rx_length = 0U;
  uint8_t rx_spoiled = 0U;
  uint8_t left_percent = 0U;
  uint8_t right_percent = 0U;
  uint8_t link_live = 0U;
  uint32_t rejected = 0U;
  uint32_t last_command_tick = 0U;
  uint32_t last_status_tick = 0U;
  char status_message[48];
  /* USER CODE END 1 */

  /* MPU Configuration--------------------------------------------------------*/
  MPU_Config();

  /* MCU Configuration--------------------------------------------------------*/

  /* Reset of all peripherals, Initializes the Flash interface and the Systick. */
  HAL_Init();

  /* Configure the system clock */
  SystemClock_Config();

  /* Initialize all configured peripherals */
  MX_GPIO_Init();
  MX_ADC1_Init();
  MX_TIM1_Init();
  MX_TIM3_Init();
  MX_TIM4_Init();
  MX_ADC2_Init();
  MX_USART1_UART_Init();
  /* USER CODE BEGIN 2 */
  /* Keep both motor drivers asleep until a valid Bluetooth wheel frame. */
  HAL_GPIO_WritePin(NSLEEP_HB_1_GPIO_Port, NSLEEP_HB_1_Pin, GPIO_PIN_RESET);
  HAL_GPIO_WritePin(NSLEEP_HB_2_GPIO_Port, NSLEEP_HB_2_Pin, GPIO_PIN_RESET);

  /* Start PWM with every input at 0% duty, then keep both drivers asleep. */
  if (HAL_TIM_PWM_Start(&htim4, MO1_IN1) != HAL_OK ||
      HAL_TIM_PWM_Start(&htim4, MO1_IN2) != HAL_OK ||
      HAL_TIM_PWM_Start(&htim4, MO2_IN1) != HAL_OK ||
      HAL_TIM_PWM_Start(&htim4, MO2_IN2) != HAL_OK)
  {
    Error_Handler();
  }

  Motors_Stop();
  HAL_UART_Transmit(&huart1, (uint8_t *)identity,
                    sizeof(identity) - 1U, 100U);
  last_status_tick = HAL_GetTick();
  /* USER CODE END 2 */

  /* Infinite loop */
  /* USER CODE BEGIN WHILE */
  while (1)
  {
    /* USER CODE END WHILE */

    /* USER CODE BEGIN 3 */
    HAL_StatusTypeDef receive_status =
        HAL_UART_Receive(&huart1, &received_byte, 1U, 5U);

    if (receive_status == HAL_OK)
    {
      if (received_byte == '\n')
      {
        if (rx_spoiled != 0U)
        {
          rejected++;
        }
        else if (rx_length == 1U && rx_line[0] == '?')
        {
          HAL_UART_Transmit(&huart1, (uint8_t *)identity,
                            sizeof(identity) - 1U, 100U);
        }
        else if (rx_length != 0U &&
                 Parse_Wheel_Command(rx_line, rx_length,
                                     &left_percent, &right_percent) != 0U)
        {
          Motors_SetWheelPercent(left_percent, right_percent);
          last_command_tick = HAL_GetTick();
          link_live = 1U;
        }
        else if (rx_length != 0U)
        {
          rejected++;
        }
        rx_length = 0U;
        rx_spoiled = 0U;
      }
      else if (received_byte == '\r')
      {
        /* Accept CRLF as well as LF. */
      }
      else if (rx_length < sizeof(rx_line))
      {
        rx_line[rx_length++] = (char)received_byte;
      }
      else
      {
        rx_spoiled = 1U;
      }
    }
    else if (receive_status != HAL_TIMEOUT)
    {
      rx_length = 0U;
      rx_spoiled = 0U;
      rejected++;
      __HAL_UART_CLEAR_OREFLAG(&huart1);
    }

    uint32_t now = HAL_GetTick();
    if (link_live != 0U && now - last_command_tick > LINK_TIMEOUT_MS)
    {
      Motors_Stop();
      left_percent = 0U;
      right_percent = 0U;
      link_live = 0U;
    }

    if (now - last_status_tick >= STATUS_PERIOD_MS)
    {
      int length = snprintf(status_message, sizeof(status_message),
                            "S %s %u %u %lu\r\n",
                            link_live != 0U ? "pc" : "idle",
                            (unsigned int)left_percent,
                            (unsigned int)right_percent,
                            (unsigned long)rejected);
      if (length > 0)
      {
        HAL_UART_Transmit(&huart1, (uint8_t *)status_message,
                          (uint16_t)length, 100U);
      }
      last_status_tick = now;
    }
  }
  /* USER CODE END 3 */
}

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
 /* MPU Configuration */

void MPU_Config(void)
{
  MPU_Region_InitTypeDef MPU_InitStruct = {0};

  /* Disables the MPU */
  HAL_MPU_Disable();

  /** Initializes and configures the Region and the memory to be protected
  */
  MPU_InitStruct.Enable = MPU_REGION_ENABLE;
  MPU_InitStruct.Number = MPU_REGION_NUMBER0;
  MPU_InitStruct.BaseAddress = 0x0;
  MPU_InitStruct.Size = MPU_REGION_SIZE_4GB;
  MPU_InitStruct.SubRegionDisable = 0x87;
  MPU_InitStruct.TypeExtField = MPU_TEX_LEVEL0;
  MPU_InitStruct.AccessPermission = MPU_REGION_NO_ACCESS;
  MPU_InitStruct.DisableExec = MPU_INSTRUCTION_ACCESS_DISABLE;
  MPU_InitStruct.IsShareable = MPU_ACCESS_SHAREABLE;
  MPU_InitStruct.IsCacheable = MPU_ACCESS_NOT_CACHEABLE;
  MPU_InitStruct.IsBufferable = MPU_ACCESS_NOT_BUFFERABLE;

  HAL_MPU_ConfigRegion(&MPU_InitStruct);
  /* Enables the MPU */
  HAL_MPU_Enable(MPU_PRIVILEGED_DEFAULT);

}

/**
  * @brief  This function is executed in case of error occurrence.
  * @retval None
  */
void Error_Handler(void)
{
  /* USER CODE BEGIN Error_Handler_Debug */
  /* User can add his own implementation to report the HAL error return state */
  __disable_irq();
  while (1)
  {
  }
  /* USER CODE END Error_Handler_Debug */
}
#ifdef USE_FULL_ASSERT
/**
  * @brief  Reports the name of the source file and the source line number
  *         where the assert_param error has occurred.
  * @param  file: pointer to the source file name
  * @param  line: assert_param error line source number
  * @retval None
  */
void assert_failed(uint8_t *file, uint32_t line)
{
  /* USER CODE BEGIN 6 */
  /* User can add his own implementation to report the file name and line number,
     ex: printf("Wrong parameters value: file %s on line %d\r\n", file, line) */
  /* USER CODE END 6 */
}
#endif /* USE_FULL_ASSERT */
