Nahaa0711/Micromouse-UofT/firmware/micromouseFirmware/micromouseFirmware.ioc

Mcu.UserName=STM32F746VETx
PA10.Signal=USART1_RX
PA13.Signal=SYS_JTMS-SWDIO
PA14.Signal=SYS_JTCK-SWCLK
PA2.GPIO_Label=VISEN_1
PA2.Signal=ADCx_IN2
PA3.GPIO_Label=VISEN_2
PA3.Signal=ADCx_IN3
PA6.GPIO_Label=Encoder_A_2
PA6.Signal=S_TIM3_CH1
PA7.GPIO_Label=Encoder_B_2
PA7.Signal=S_TIM3_CH2
PA9.Signal=USART1_TX
PB0.Signal=GPIO_Output
PB4.GPIO_Label=BT_EN
PB4.Signal=GPIO_Input
PB5.GPIO_Label=BT_STATE
PB5.Signal=GPIO_Input
PC14/OSC32_IN.Signal=RCC_OSC32_IN
PC15/OSC32_OUT.Signal=RCC_OSC32_OUT
PD12.GPIO_Label=MO1_IN1
PD12.Signal=S_TIM4_CH1
PD13.GPIO_Label=MO1_IN2
PD13.Signal=S_TIM4_CH2
PD14.GPIO_Label=MO2_IN1
PD14.Signal=S_TIM4_CH3
PD15.GPIO_Label=MO2_IN2
PD15.Signal=S_TIM4_CH4
PE10.GPIO_Label=NSLEEP_HB_2
PE10.Signal=GPIO_Output
PE11.GPIO_Label=Encoder_B_1
PE11.Signal=S_TIM1_CH2
PE7.GPIO_Label=NSLEEP_HB_1
PE7.Signal=GPIO_Output
PE9.GPIO_Label=Encoder_A_1
PE9.Signal=S_TIM1_CH1
PH0/OSC_IN.Signal=RCC_OSC_IN
PH1/OSC_OUT.Signal=RCC_OSC_OUT
