Nahaa0711/Micromouse-UofT/firmware/micromouseFirmware/Core/Inc/main.h

#define VISEN_1_Pin GPIO_PIN_2
#define VISEN_1_GPIO_Port GPIOA
#define VISEN_2_Pin GPIO_PIN_3
#define VISEN_2_GPIO_Port GPIOA
#define Encoder_A_2_Pin GPIO_PIN_6
#define Encoder_A_2_GPIO_Port GPIOA
#define Encoder_B_2_Pin GPIO_PIN_7
#define Encoder_B_2_GPIO_Port GPIOA
#define NSLEEP_HB_1_Pin GPIO_PIN_7
#define NSLEEP_HB_1_GPIO_Port GPIOE
#define Encoder_A_1_Pin GPIO_PIN_9
#define Encoder_A_1_GPIO_Port GPIOE
#define NSLEEP_HB_2_Pin GPIO_PIN_10
#define NSLEEP_HB_2_GPIO_Port GPIOE
#define Encoder_B_1_Pin GPIO_PIN_11
#define Encoder_B_1_GPIO_Port GPIOE
#define MO1_IN1_Pin GPIO_PIN_12
#define MO1_IN1_GPIO_Port GPIOD
#define MO1_IN2_Pin GPIO_PIN_13
#define MO1_IN2_GPIO_Port GPIOD
#define MO2_IN1_Pin GPIO_PIN_14
#define MO2_IN1_GPIO_Port GPIOD
#define MO2_IN2_Pin GPIO_PIN_15
#define MO2_IN2_GPIO_Port GPIOD
#define BT_EN_Pin GPIO_PIN_4
#define BT_EN_GPIO_Port GPIOB
#define BT_STATE_Pin GPIO_PIN_5
#define BT_STATE_GPIO_Port GPIOB
