Nahaa0711/Micromouse-UofT/(commit log)

2025-10-28 Added micromouse master schematic template in ./Micromouse
2025-10-28 I lied before, here are the schematics
    [ICM-42688-P.step, LIS2MDLTR.step, MicromouseSchematic.kicad_pcb, MicromouseSchematic.kicad_sch, TPSM861253RDXR.step, VL6180V1NR_1.step, imumagnetometer.kicad_sch, motordrivers.kicad_sch]
2025-10-31 tof version 1
    [LP5907MFX-2.8_NOPB.step, MicromouseSchematic.kicad_sch, TCA9544APWR.step, tof.kicad_sch, voltagereg.kicad_sch]
2025-11-08 Added microcontroller schematics
    [MicromouseSchematic.kicad_sch]
2025-11-15 changed motor driver schematics
    [MicromouseSchematic.kicad_sch, motordrivers.kicad_sch, voltagereg.kicad_sch]
2025-11-15 Updated IMU and Magnetometer schematics
    [imumagnetometer.kicad_sch]
2025-11-15 Made changesto IMU/magnetometer
    [MicromouseSchematic.kicad_sch, imumagnetometer.kicad_sch]
2025-11-16 Added IR, programming header, i2c & timer pins
    [MicromouseSchematic.kicad_sch, irsens.kicad_sch, motordrivers.kicad_sch, voltagereg.kicad_sch]
2025-11-22 added some stuff
    [LP5907MFX-2.8_NOPB.step, MicromouseSchematic.kicad_sch, imumagnetometer.kicad_sch, irsens.kicad_sch, motordrivers.kicad_sch, tof.kicad_sch, voltagereg.kicad_sch]
2025-11-22 updated stuff
    [ICM-42688-P.step, LIS2MDLTR.step, MicromouseSchematic.kicad_sch, TCA9544APWR.step, TPSM861253RDXR.step, VL6180V1NR_1.step, imumagnetometer.kicad_sch, motordrivers.kicad_sch]
2026-04-02 Micromouse KiCad: MP6550 libs in project, fp-lib paths, schematic updates
    Move MP6550G-Z symbol and legacy footprints into MicromouseSchematic, add
    MP6550G-Z.pretty with MP6550_MNP footprint, and point fp-lib-table at the
    project-local MM_MP6550G-Z library.
    Replace old absolute footprint paths with this repo’s Micromouse tree and
    MM_* library names. Update root schematic and IMU/IR/motor/TOF/regulator
    subsheets; add empty bluethooth.kicad_sch hierarchical sheet. Extend KiCad
    project BOM field configuration; refresh fp-info-cache. Drop schematic lock
    file; include dated schematic backup zip.
    [MicromouseSchematic.kicad_sch, bluethooth.kicad_sch, imumagnetometer.kicad_sch, irsens.kicad_sch, motordrivers.kicad_sch, tof.kicad_sch, voltagereg.kicad_sch]
2026-04-09 Micromouse KiCad: STM32-centric routing; ERC errors 23→6; backups and gitignore
    Body:
    Connected almost all STM32 signals; ERC down to 6
    Rework root schematic plus motor driver, IMU/magnetometer, IR sensor, and TOF
    subsheets so the bulk of signals reach the STM32. KiCad ERC is not fully clean
    yet, but major nets are in place: errors dropped from 23 to 6 while many
    previously unconnected signals were wired.
    Add 2026-04-08 schematic backup zips. Extend .gitignore for macOS .DS_Store
    paths. Update MicromouseSchematic.kicad_prl.
    [MicromouseSchematic.kicad_sch, imumagnetometer.kicad_sch, irsens.kicad_sch, motordrivers.kicad_sch, tof.kicad_sch]
2026-04-12 Micromouse KiCad: MP6550 layout, schematic updates; ERC clean, warnings ~5–6
    Relocate MP6550G-Z symbol and footprint trees from MicromouseSchematic into
    Micromouse/MP6550G-Z and refresh sym-lib-table (portable ${KIPRJMOD} paths
    where applicable, MP6550 at new location).
    Update root schematic plus IMU, IR, motor driver, and TOF subsheets. KiCad
    ERC: all errors resolved (previously 6 remaining after earlier bring-up).
    Warnings reduced from roughly 35–40+ down to about 5–6.
    Add MicromouseSchematic-2026-04-11_212024.zip backup.
    [MicromouseSchematic.kicad_sch, imumagnetometer.kicad_sch, irsens.kicad_sch, motordrivers.kicad_sch, tof.kicad_sch]
2026-04-18 fix: footprint errors and add setup guide
    [imumagnetometer.kicad_sch, irsens.kicad_sch, motordrivers.kicad_sch, tof.kicad_sch, voltagereg.kicad_sch]
2026-04-18 fixed sym erc violation
    [imumagnetometer.kicad_sch]
2026-04-18 udpated programming header
    [MicromouseSchematic.kicad_sch]
2026-04-22 assigned capacitor footprints. still have to figure out rest
    [MicromouseSchematic.kicad_sch, imumagnetometer.kicad_sch, irsens.kicad_sch, motordrivers.kicad_sch, tof.kicad_sch, voltagereg.kicad_sch]
2026-04-22 added resistors, must need to add capacitors
    [MicromouseSchematic.kicad_sch, imumagnetometer.kicad_sch, irsens.kicad_sch, motordrivers.kicad_sch, tof.kicad_sch, voltagereg.kicad_sch]
2026-04-25 Changd IR sensors and emmiters to 5mm LEDs
    [MicromouseSchematic.kicad_pcb, MicromouseSchematic.kicad_sch, imumagnetometer.kicad_sch, irsens.kicad_sch, motordrivers.kicad_sch, tof.kicad_sch, voltagereg.kicad_sch]
2026-04-25 Cleared all footprint errors and issues. Updated crystal caps to match Cload
    [MicromouseSchematic.kicad_sch, irsens.kicad_sch, motordrivers.kicad_sch]
2026-04-25 Micromouse KiCad: VL53L4 TOF footprint/sym; fp-lib via KICAD_ADDITIONAL_FOOTPRINT
    Add UltraLibrarian VL53L4CDV0DH-1 KiCad symbol and LGA12_STM footprint plus
    vendor readme; register them in sym-lib-table and fp-lib-table.
    Point MM footprint libraries at ${KICAD_ADDITIONAL_FOOTPRINT}/... for
    portable paths; add MM_VL53L4CDV0DH-1.
    Rework tof.kicad_sch (large cleanup vs embedded library bulk) and touch root
    MicromouseSchematic.kicad_sch and MicromouseSchematic.kicad_pro for project
    consistency.
    [MicromouseSchematic.kicad_sch, tof.kicad_sch]
2026-04-29 added resistors
    [tof.kicad_sch]
2026-04-30 Schematics clear, moved all footprints to pcb and voltage regulator completed. The layout begins
    [MicromouseSchematic.kicad_pcb, MicromouseSchematic.kicad_sch, untitled.kicad_sch, voltagereg.kicad_sch]
2026-04-30 to-do IMU+Mag figure it out or mutli layer pcb?
    [MicromouseSchematic.kicad_pcb, imumagnetometer.kicad_sch, voltagereg.kicad_sch]
2026-05-02 added ir sensors stuff
    [IR_Sensor.kicad_sch, MicromouseSchematic.kicad_pcb, irsens.kicad_sch]
2026-08-01 Fixed motor driver
    [IR_Sensor.kicad_sch, MicromouseSchematic.kicad_sch, bluethooth.kicad_sch, imumagnetometer.kicad_sch, irsens.kicad_sch, motordrivers.kicad_sch, tof.kicad_sch, voltagereg.kicad_sch]
2026-08-05 Schematic overhaul
    [IR_Sensor.kicad_sch, IR_sensor_project.kicad_pcb, IR_sensor_project.kicad_sch, MicromouseSchematic.kicad_pcb, MicromouseSchematic.kicad_sch, ToF_sensor_project.kicad_pcb, ToF_sensor_project.kicad_sch, bluethooth.kicad_sch]
2026-08-07 Prepped layout
    [MicromouseSchematic.kicad_pcb, MicromouseSchematic.kicad_sch, imumagnetometer.kicad_sch, irsens.kicad_sch, motordrivers.kicad_sch, pcb_shape.DXF, tof.kicad_sch, voltagereg.kicad_sch]
2026-08-26 Finished layout
    [MicromouseSchematic.kicad_pcb, MicromouseSchematic.kicad_sch, imumagnetometer.kicad_sch, irsens.kicad_sch, motordrivers.kicad_sch, voltagereg.kicad_sch]
2026-09-18 Cleaned up layout
    [MicromouseSchematic.kicad_pcb, ToF_sensor_project.kicad_pcb, ToF_sensor_project.kicad_sch]
2026-10-29 Completed IR board, ToF board, changed IMU
2026-11-05 V1 finalized + gerber files
2026-11-09 motor firmware
2026-11-09 Bluetooth motor control firmware
2026-11-13 Added mind to motor firmware
